pavit15/softquad/CAD_Design/README.md

# <ins>CAD Design
## <ins>Rigid Bot PArts:
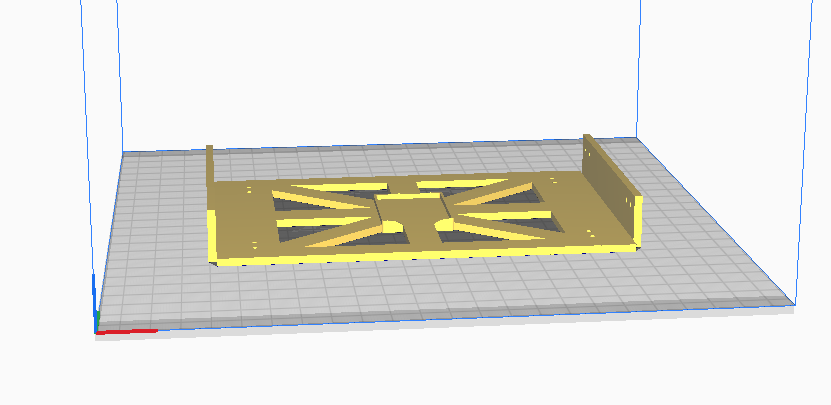
[picture p1: CAD_Design/assets/RigidChasis.png]


Rigid Bot Chasis Design

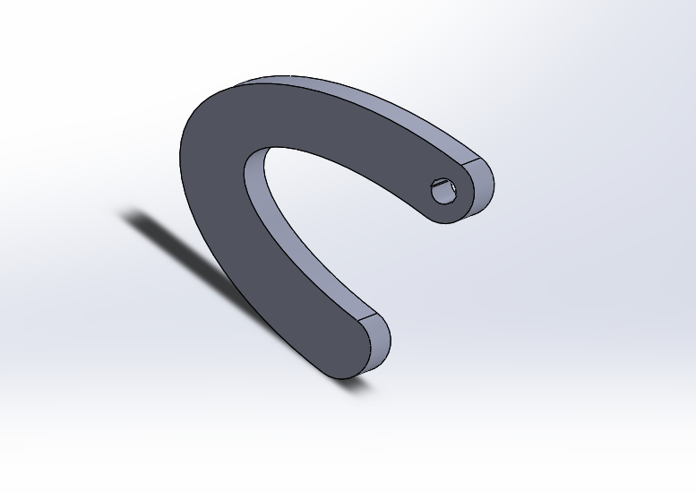
[picture p2: CAD_Design/assets/RigidLeg.png]


Rigid Leg Chasis Design

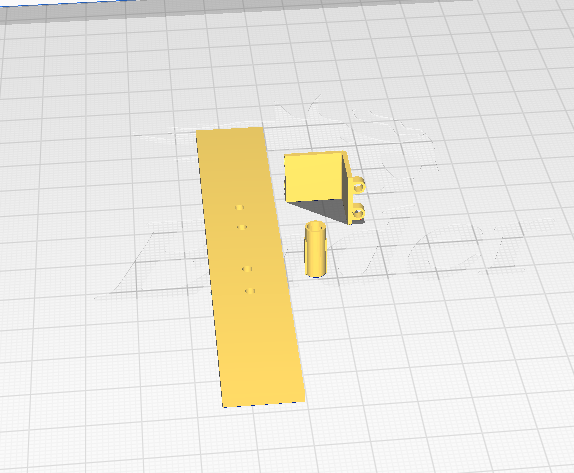
[picture p3: CAD_Design/assets/RigidParts.png]


Other parts used in Bot

## <ins>Asembly of Bot:



Motion of Bot Assembly

## <ins>Molds used for Soft Part Fabrication:
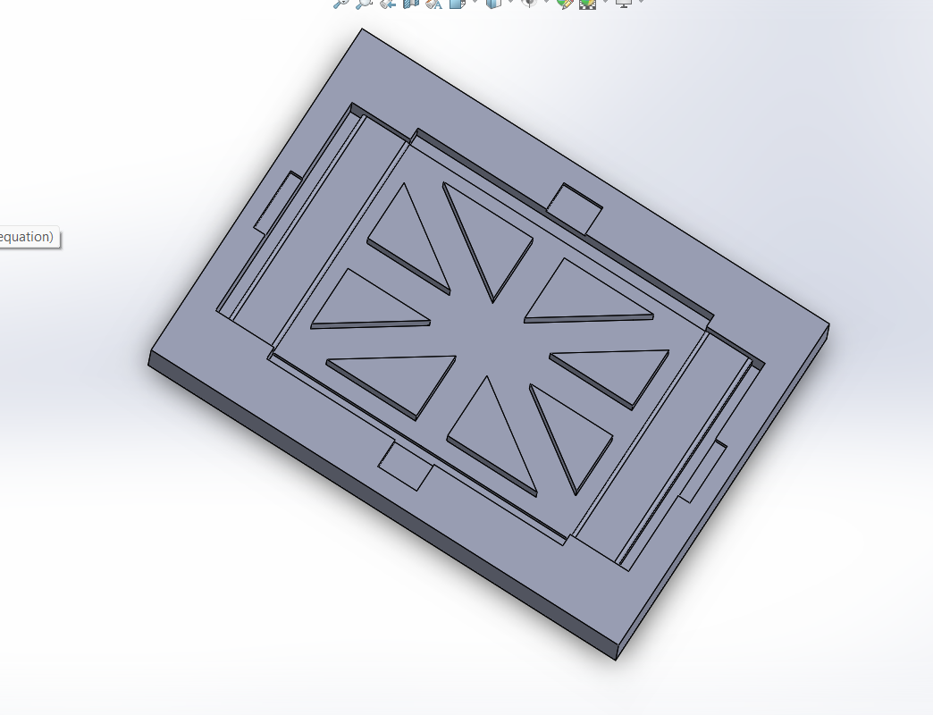
[picture p4: CAD_Design/assets/BodyMold.png]


Body Mold

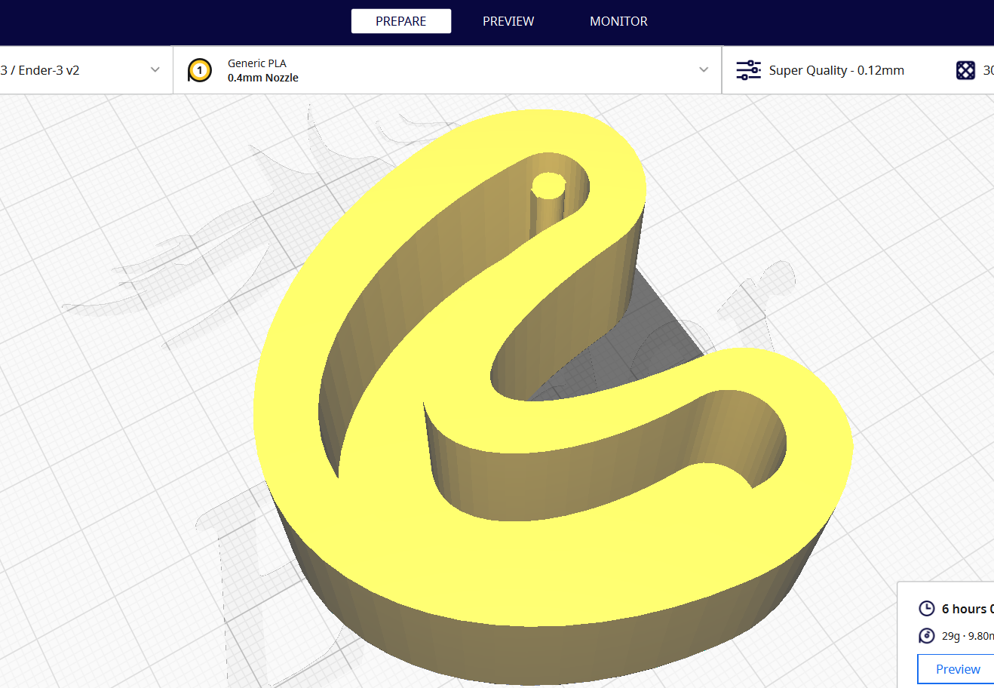
[picture p5: CAD_Design/assets/LegMold.png]


Leg Mold
