pavit15/softquad/CAD_Design/Assembly/RigidBot Assembly.SLDASM

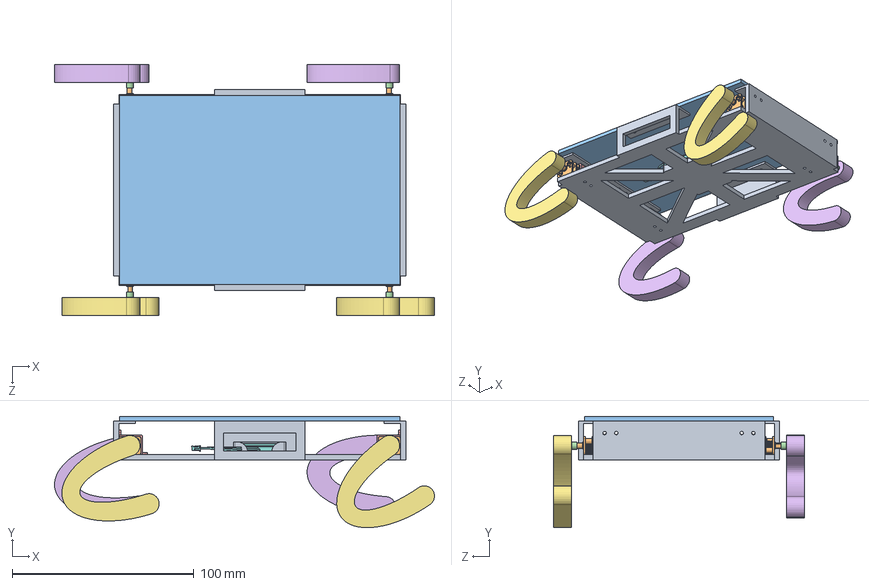
[picture p6: CAD file, 2023-11-04]
CAD_Design/Assembly/RigidBot Assembly.SLDASM
209.3 x 61.3 x 138.4 mm
RigidBody
n20_motor x 4
perfeg
ConnectorRB x 4
N20Bracket x 4
Rigid leg x 2
Rigid legL x 2
3.7v li-ion 500mah Battery.step
