pavit15/softquad/CAD_Design/Components/n20_motor.SLDPRT

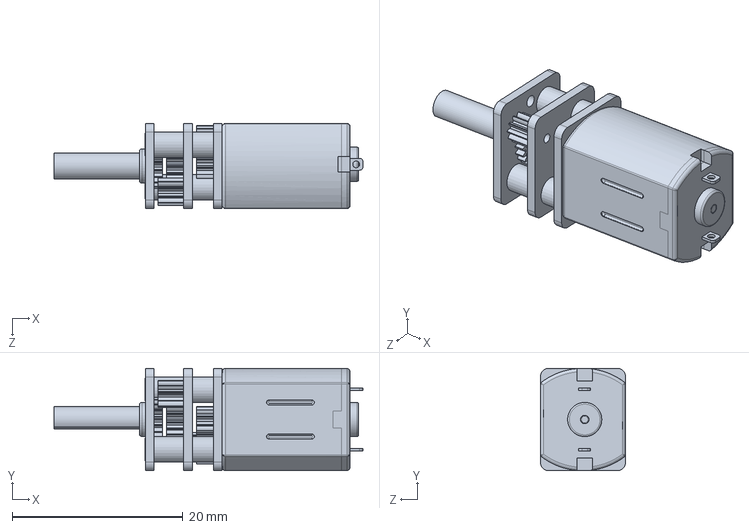
[picture p7: CAD file, 2023-11-04]
CAD_Design/Components/n20_motor.SLDPRT
36.2 x 12.0 x 10.0 mm
