pavit15/softquad/CAD_Design/Rigid_Bot_Design/ConnectorRB.SLDPRT

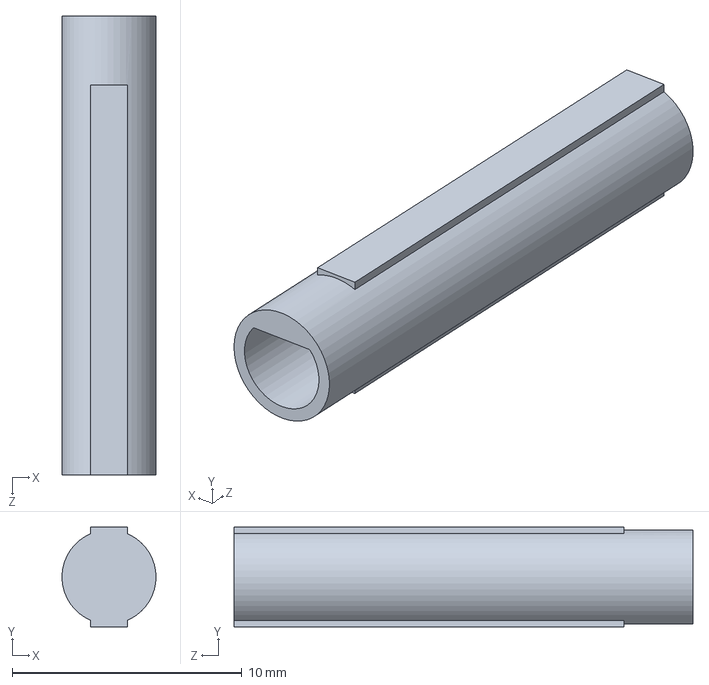
[picture p8: CAD file, 2023-11-04]
CAD_Design/Rigid_Bot_Design/ConnectorRB.SLDPRT
4.10 x 4.35 x 20.0 mm
