pavit15/softquad/CAD_Design/Soft_Quad_Molds/bodymold.SLDPRT

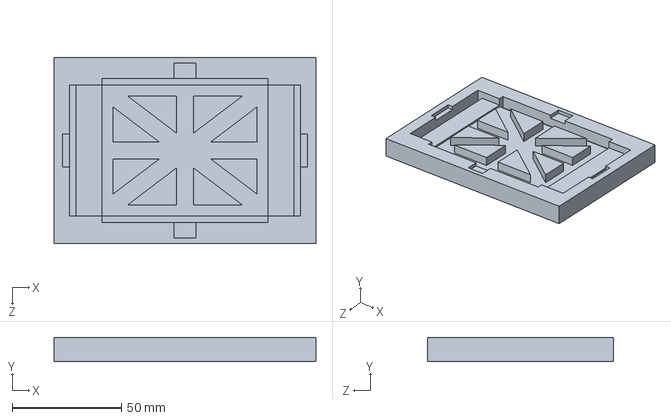
[picture p9: CAD file, 2023-11-04]
CAD_Design/Soft_Quad_Molds/bodymold.SLDPRT
120.0 x 11.0 x 85.0 mm
