pavit15/softquad/CAD_Design/STL_Files/clamps.STL

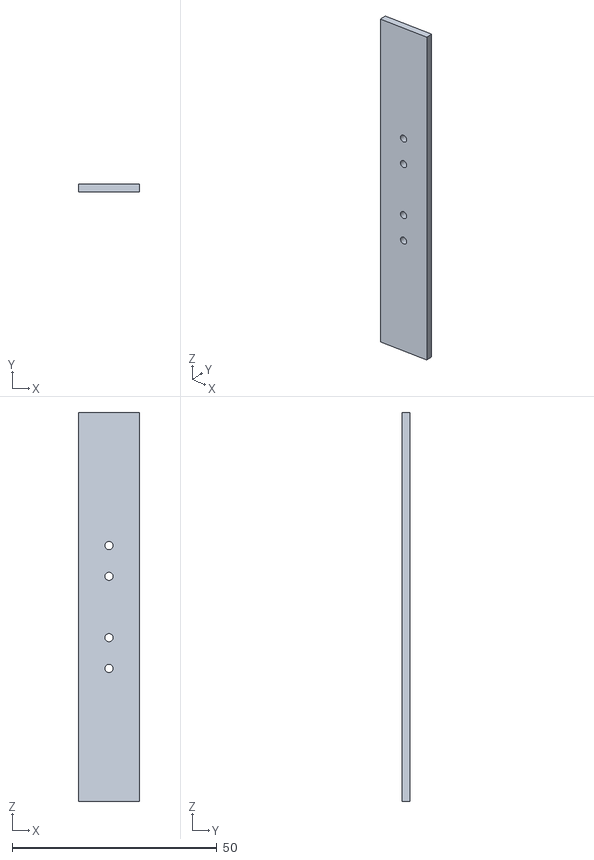
[picture p10: CAD file, 2023-11-04]
CAD_Design/STL_Files/clamps.STL
15.0 x 2.00 x 95.0
