pavit15/softquad/Kicad Rigid PCB/SoftQuad/Components/3352T-1-504LF.step

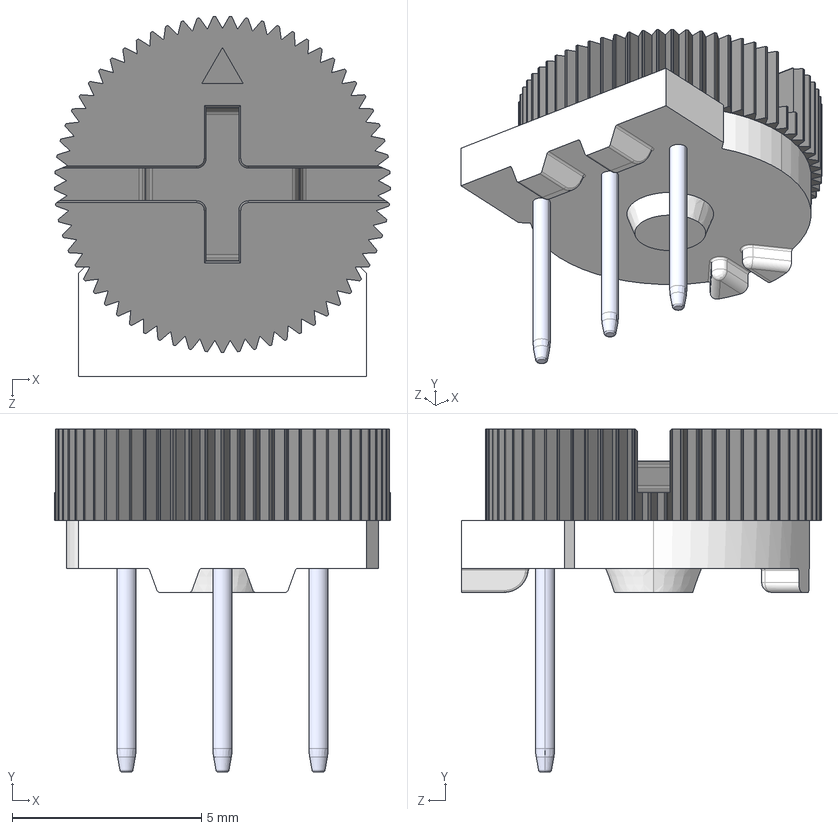
[picture p11: CAD file, 2023-11-05]
Kicad Rigid PCB/SoftQuad/Components/3352T-1-504LF.step
8.89 x 9.07 x 9.52 mm
