pavit15/softquad/Kicad Rigid PCB/XL6009.step

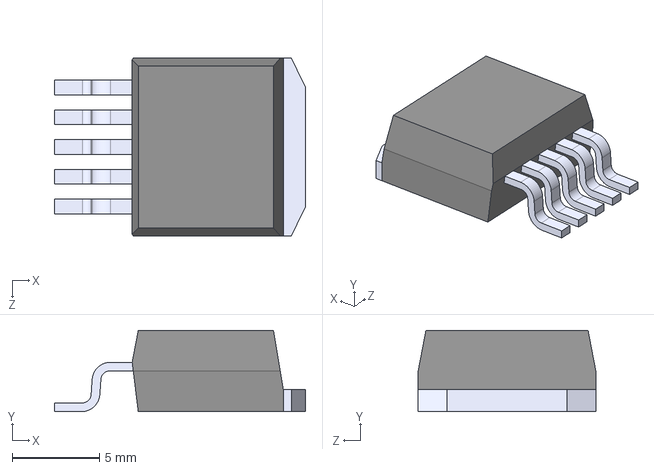
[picture p12: CAD file, 2023-11-04]
Kicad Rigid PCB/XL6009.step
14.3 x 4.65 x 10.2 mm
