pavit15/softquad/CAD_Design/Rigid_Bot_Design/N20Bracket.SLDPRT

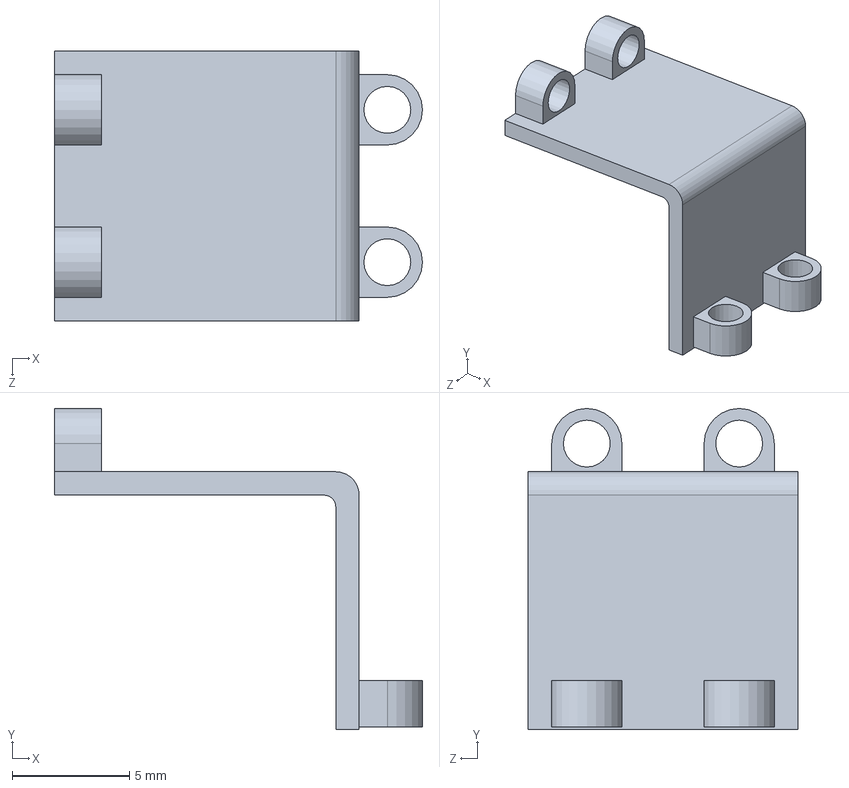
[picture p13: CAD file, 2023-11-04]
CAD_Design/Rigid_Bot_Design/N20Bracket.SLDPRT
15.7 x 13.7 x 11.5 mm
