pavit15/softquad/CAD_Design/Soft_Quad_Molds/Mold Leg.SLDPRT

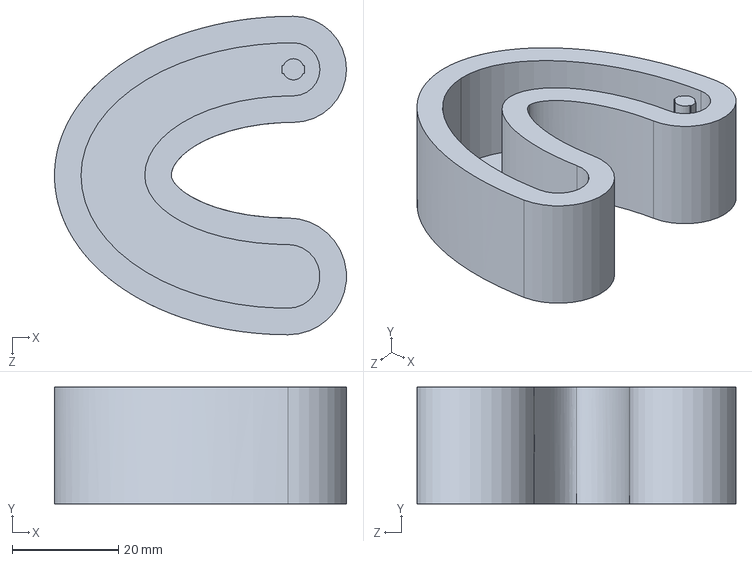
[picture p14: CAD file, 2023-11-04]
CAD_Design/Soft_Quad_Molds/Mold Leg.SLDPRT
55.0 x 22.0 x 60.0 mm
