pavit15/softquad/Kicad Rigid PCB/SoftQuad/Components/L293D.step

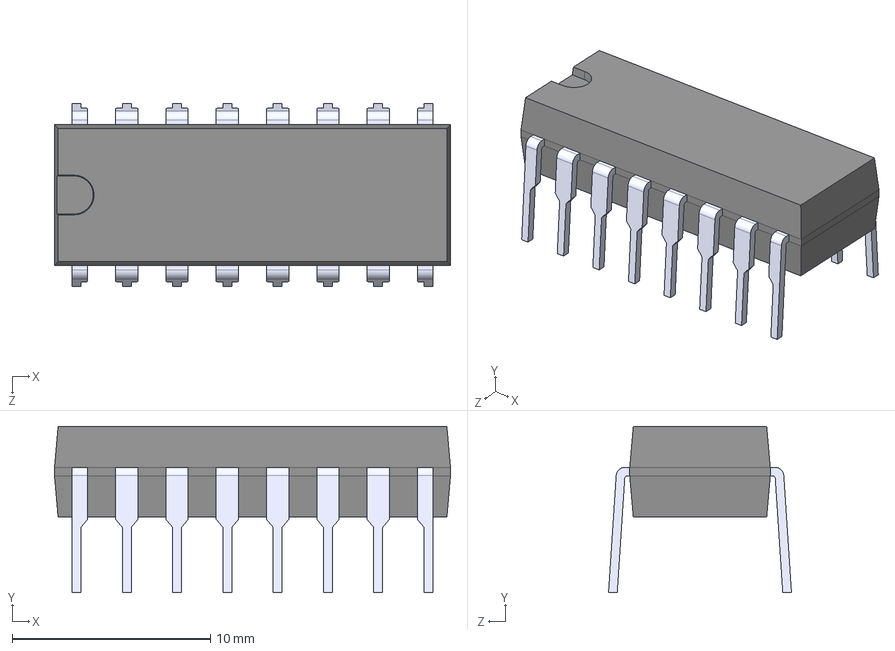
[picture p15: CAD file, 2023-11-04]
Kicad Rigid PCB/SoftQuad/Components/L293D.step
20.0 x 8.40 x 9.24 mm
