pavit15/softquad/CAD_Design/STL_Files/RigidBody.STL

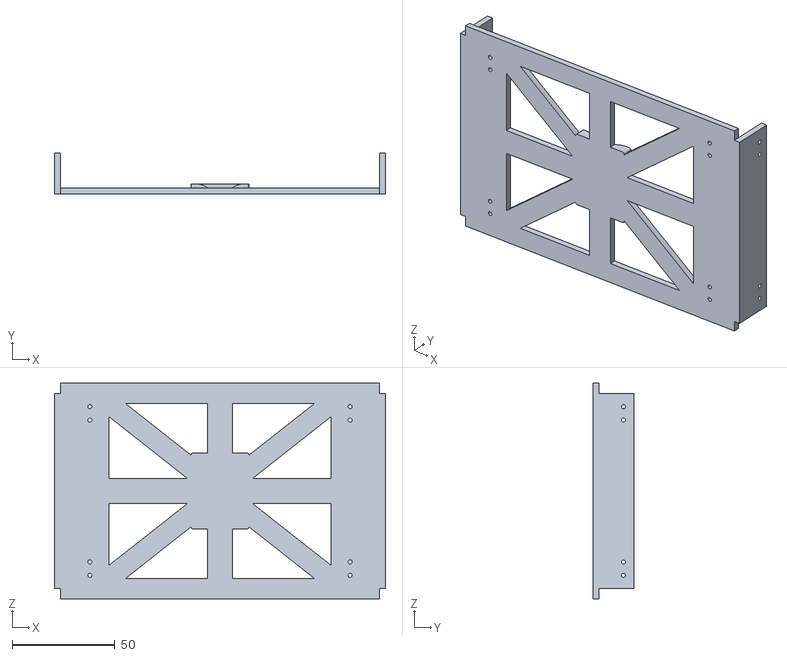
[picture p16: CAD file, 2023-11-04]
CAD_Design/STL_Files/RigidBody.STL
161.0 x 20.0 x 105.0
