pavit15/softquad/CAD_Design/Components/12V_1x02_tht.step

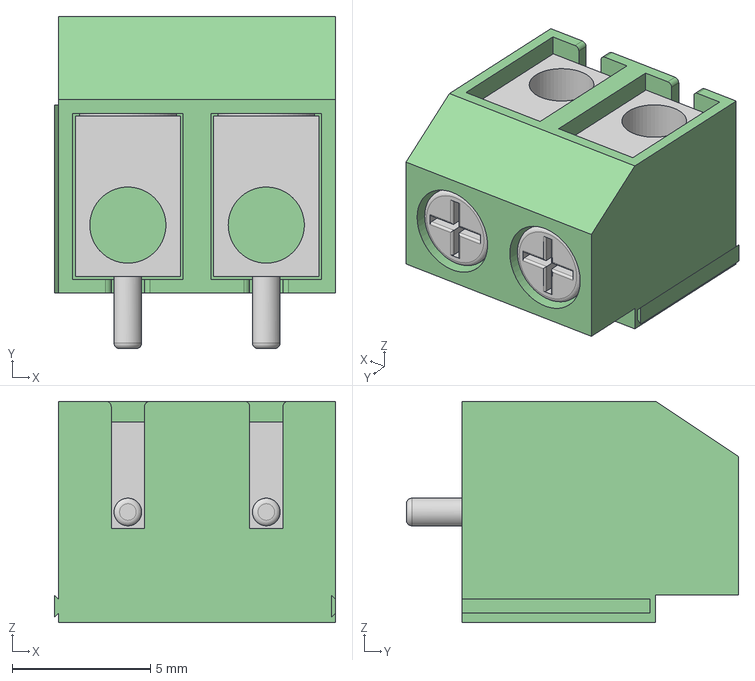
[picture p17: CAD file, 2023-11-04]
CAD_Design/Components/12V_1x02_tht.step
10.2 x 12.0 x 8.00 mm
