pavit15/softquad/CAD_Design/Rigid_Bot_Design/RigidBody.SLDPRT

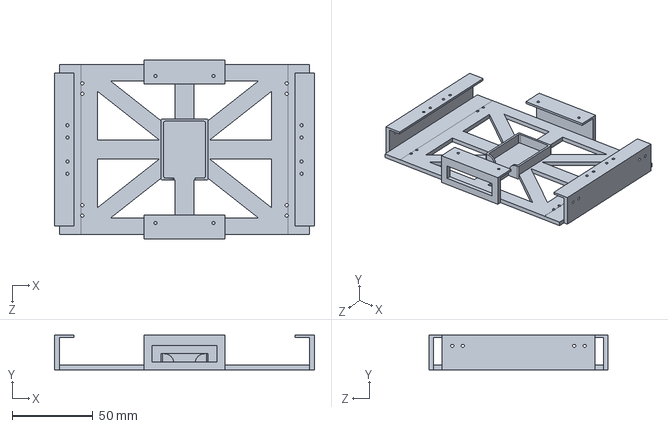
[picture p18: CAD file, 2023-11-04]
CAD_Design/Rigid_Bot_Design/RigidBody.SLDPRT
161.0 x 21.5 x 111.0 mm
