pavit15/softquad/CAD_Design/STL_Files/Rigid leg.STL

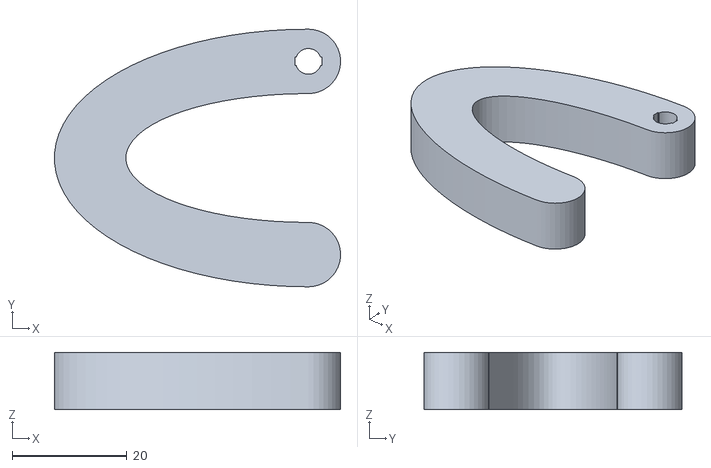
[picture p19: CAD file, 2023-11-04]
CAD_Design/STL_Files/Rigid leg.STL
50.0 x 45.0 x 10.0
