pavit15/softquad/(list of files, cad)

Other CAD files:
CAD_Design/STL_Files/N20Bracket.STL
CAD_Design/Rigid_Bot_Design/clamps.SLDPRT
CAD_Design/Rigid_Bot_Design/RigidBody1.SLDPRT
CAD_Design/STL_Files/bodymold.STL
CAD_Design/Rigid_Bot_Design/Rigid leg.SLDPRT
CAD_Design/STL_Files/ConnectorRB.STL
CAD_Design/STL_Files/Mold Leg.STL
