pavit15/softquad/(list of files, drawings)

Other design files:
Final Flex PCB/Components/4-644456-9/4-644456-9.SchLib
Final Flex PCB/Components/4-644456-9/TE_4-644456-9.PcbLib
Final Flex PCB/Components/282837-2/282837-2.SchLib
Final Flex PCB/Components/282837-2/TE_282837-2.PcbLib
Final Flex PCB/Components/CPF0603B1K0E1/CPF0603B1K0E1.SchLib
Final Flex PCB/Components/CPF0603B1K0E1/RESC1608X50N.PcbLib
Final Flex PCB/Components/L293DD/SnapEDApcb.PcbLib
Final Flex PCB/Components/L293DD/SnapEDAsch.SchLib
Final Flex PCB/Components/SS34/DIOM7959X265N.PcbLib
Final Flex PCB/Components/SS34/SS34.SchLib
Final Flex PCB/Components/TLV1117LV18DCYR/SOT230P700X180-4N.PcbLib
Final Flex PCB/Components/TLV1117LV18DCYR/TLV1117LV18DCYR.SchLib
Final Flex PCB/Components/TMS-101-02-G-D-RA/SAMTEC_TMS-101-02-G-D-RA.PcbLib
Final Flex PCB/Components/TMS-101-02-G-D-RA/TMS-101-02-G-D-RA.SchLib
Final Flex PCB/Components/TMS-101-02-G-D/SAMTEC_TMS-101-02-G-D.PcbLib
Final Flex PCB/Components/TMS-101-02-G-D/TMS-101-02-G-D.SchLib
Final Flex PCB/Components/XL6009/DPAK170P1435X465-6N.PcbLib
Final Flex PCB/Components/XL6009/XL6009.SchLib
Final Flex PCB/PCB1.PcbDoc
Final Flex PCB/Soft Quad Schematic.SchDoc
Final Flex PCB/Soft Quad.PrjPcb
