pavit15/softquad/Kicad Rigid PCB/SoftQuad/SoftQuad.kicad_pcb

## KiCad design Kicad Rigid PCB/SoftQuad/SoftQuad.kicad_pcb (2023-11-05)

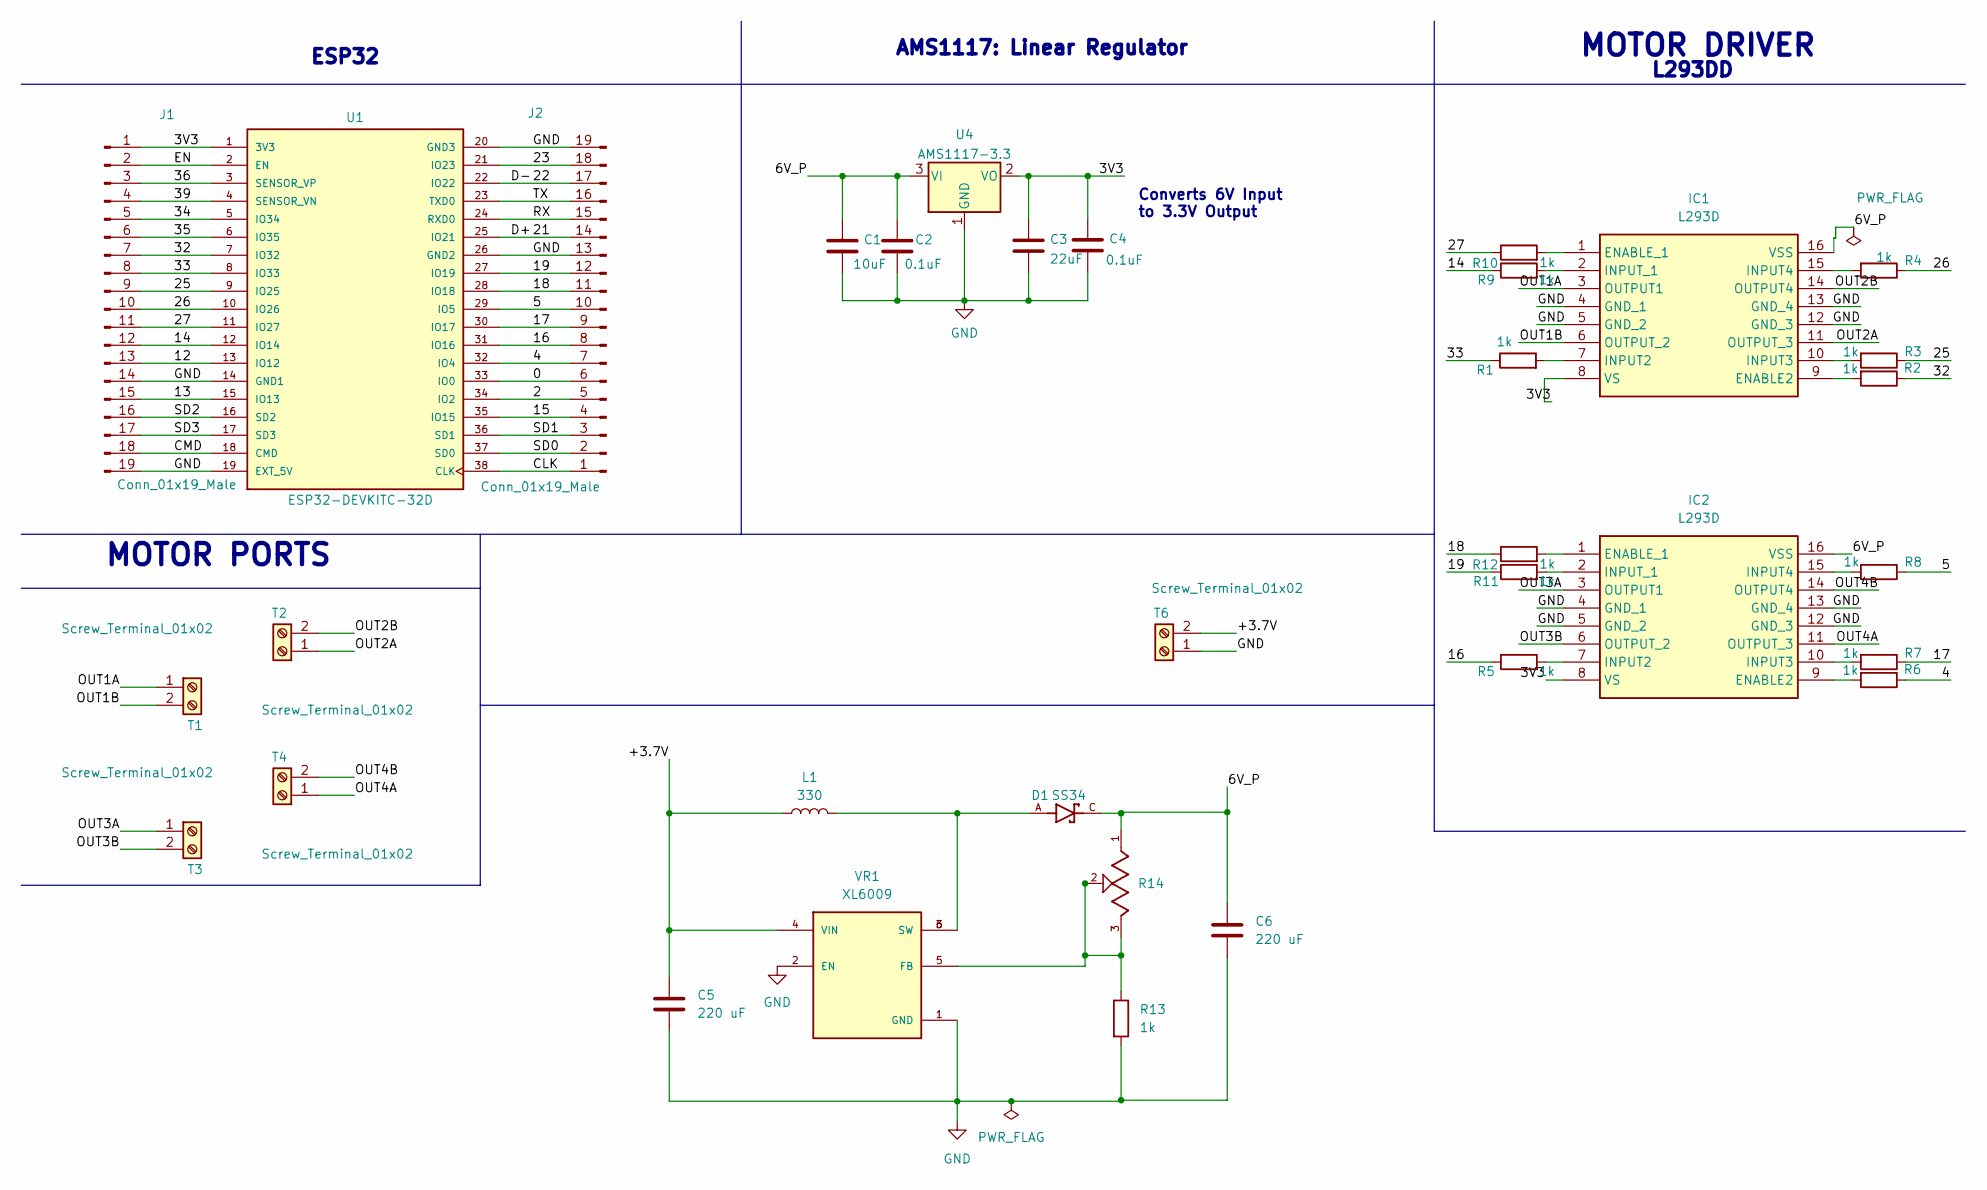
[picture p20: schematic SoftQuad.kicad_sch]

Parts:
C1: 10uF; C_0603_1608Metric
C2, C4: 0.1uF; C_0603_1608Metric
C3: 22uF; C_0603_1608Metric
C5, C6: 220 uF; C_0201_0603Metric
D1: SS34; DIOM7959X265N; PARTREV 31 Aug 2016
IC1, IC2: L293D; DIP880W50P254L2000H510Q16N; Manufacturer_Part_Number L293D; Mouser Part Number 511-L293D
J1, J2: Conn_01x19_Male; 1X19
L1: 330; L_0201_0603Metric
R1, R2, R3, R4, R5, R6, R7, R8, R9, R10, R11, R12, R13: 1k; R_0201_0603Metric
R14: 10k; TRIM_3352T-1-504LF; PARTREV 08/19
T1, T2, T3, T4, T6: Screw_Terminal_01x02; TerminalBlock_bornier-2_P5.08mm
U1: ESP32-DEVKITC-32D; ESP32-DEVKITCv4-32D; PARTREV 4
U4: AMS1117-3.3; SOT-223-3_TabPin2
VR1: XL6009; DPAK170P1435X465-6N; PARTREV 1.1

Connections:
/0: J2.6, U1.33 (IO0)
/2: J2.5, U1.34 (IO2)
/3V3: C3.1, C4.1, IC1.8 (VS), IC2.8 (VS), U1.1 (3V3), U4.2 (VO)
/4: R6.1, U1.32 (IO4)
/5: R8.1, U1.29 (IO5)
/6V_P: C1.1, C2.1, C6.1, D1.C, IC1.16 (VSS), IC2.16 (VSS), R14.1, U4.3 (VI)
/12: J1.13, U1.13 (IO12)
/13: J1.15, U1.15 (IO13)
/14: R9.1, U1.12 (IO14)
/15: J2.4, U1.35 (IO15)
/16: R5.1, U1.31 (IO16)
/17: R7.1, U1.30 (IO17)
/18: J2.11, R12.1, U1.28 (IO18)
/19: J2.12, R11.1, U1.27 (IO19)
/21: J2.14, U1.25 (IO21)
/22: J2.17, U1.22 (IO22)
/23: J2.18, U1.21 (IO23)
/25: R3.1, U1.9 (IO25)
/26: R4.1, U1.10 (IO26)
/27: R10.1, U1.11 (IO27)
/32: R2.1, U1.7 (IO32)
/33: R1.1, U1.8 (IO33)
/34: J1.5, U1.5 (IO34)
/35: J1.6, U1.6 (IO35)
/36: J1.3, U1.3 (SENSOR_VP)
/39: J1.4, U1.4 (SENSOR_VN)
/+3.7V: C5.1, L1.1, T6.2, VR1.4 (VIN)
/CLK: J2.1, U1.38 (CLK)
/CMD: J1.18, U1.18 (CMD)
/EN: J1.2, U1.2 (EN)
/OUT1A: IC1.3 (OUTPUT1), T1.1
/OUT1B: IC1.6 (OUTPUT_2), T1.2
/OUT2A: IC1.11 (OUTPUT_3), T2.1
/OUT2B: IC1.14 (OUTPUT4), T2.2
/OUT3A: IC2.3 (OUTPUT1), T3.1
/OUT3B: IC2.6 (OUTPUT_2), T3.2
/OUT4A: IC2.11 (OUTPUT_3), T4.1
/OUT4B: IC2.14 (OUTPUT4), T4.2
/RX: J2.15, U1.24 (RXD0)
/SD0: J2.2, U1.37 (SD0)
/SD1: J2.3, U1.36 (SD1)
/SD2: J1.16, U1.16 (SD2)
/SD3: J1.17, U1.17 (SD3)
/TX: J2.16, U1.23 (TXD0)
GND: C1.2, C2.2, C3.2, C4.2, C5.2, C6.2, IC1.4 (GND_1), IC1.5 (GND_2), IC1.12 (GND_3), IC1.13 (GND_4), IC2.4 (GND_1), IC2.5 (GND_2), IC2.12 (GND_3), IC2.13 (GND_4), R13.2, T6.1, U1.14 (GND1), U1.19 (EXT_5V), U1.20 (GND3), U1.26 (GND2), U4.1 (GND), VR1.1 (GND), VR1.2 (EN)
unnamed: D1.A, L1.2, VR1.3 (SW), VR1.6 (SW)
unnamed: IC1.9 (ENABLE2), R2.2
unnamed: IC1.1 (ENABLE_1), R10.2
unnamed: IC1.7 (INPUT2), R1.2
unnamed: IC1.10 (INPUT3), R3.2
unnamed: IC1.15 (INPUT4), R4.2
unnamed: IC1.2 (INPUT_1), R9.2
unnamed: IC2.9 (ENABLE2), R6.2
unnamed: IC2.1 (ENABLE_1), R12.2
unnamed: IC2.7 (INPUT2), R5.2
unnamed: IC2.10 (INPUT3), R7.2
unnamed: IC2.15 (INPUT4), R8.2
unnamed: IC2.2 (INPUT_1), R11.2
unnamed: R13.1, R14.2, R14.3, VR1.5 (FB)

Notes on the sheet:
L293DD
Converts 6V Input to 3.3V Output
MOTOR DRIVER
MOTOR PORTS
ESP32
AMS1117: Linear Regulator

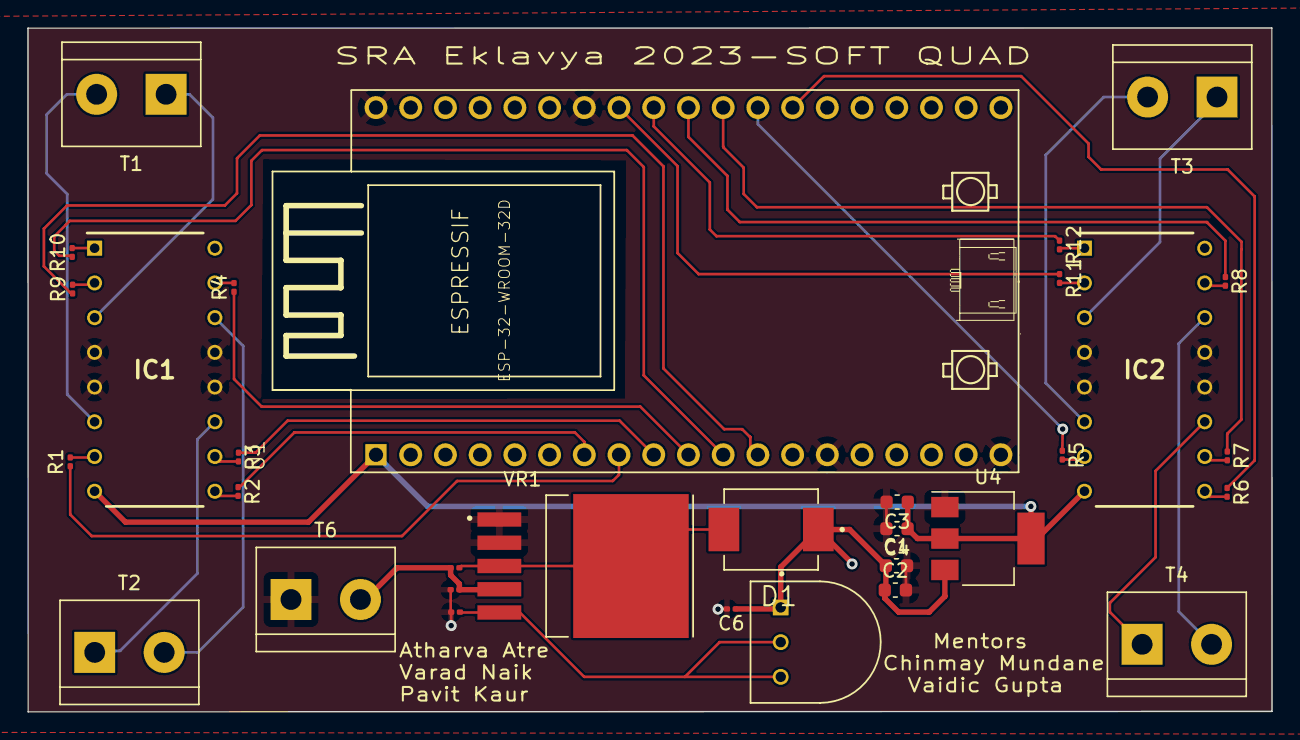
[picture p21: board SoftQuad.kicad_pcb from above]

Board: 2 copper layers, 91.0 x 50.0 mm, 32 parts (0 on the bottom side), 38 nets.
