pavit15/softquad/(threads)

Thread 5 (2023-11-02):

Add PCB_Design folder

ChinmayMundane, 2023-11-02:
- pcb folder should include 3d files, component libraries, gerbers and other necessary files

AtharvaAtre, 2023-11-05:
Issue for PCB Design solved

Closed 2023-11-05.
