pavit15/softquad/(commit log)

2023-11-04 Components used for solidworks assembly
    [12V_1x02_tht.step, L293D.step, XL6009.step, n20_motor.SLDPRT]
2023-11-04 Rigid Bot Designs
    Final Design used for 3D printing and making of Rigid Bot
    [ConnectorRB.SLDPRT, N20Bracket.SLDPRT, Rigid leg.SLDPRT, RigidBody.SLDPRT, RigidBody1.SLDPRT, clamps.SLDPRT]
2023-11-04 Mold Designs
    Molds used for Making the flexible parts
2023-11-04 Molds Solidworks
    Mold Designs used for making flexible chassis and legs
    [Mold Leg.SLDPRT, bodymold.SLDPRT]
2023-11-04 STL Files for 3D Printing
    STL files used for 3D printing the mold and parts of rigid bot
2023-11-04 STL Files used in 3D printing
    STL files used for 3D printing the parts of rigid bot and mold used in making soft bot
    [ConnectorRB.STL, Mold Leg.STL, N20Bracket.STL, Rigid leg.STL, RigidBody.STL, bodymold.STL, clamps.STL]
2023-11-04 Assembly Files
    Assembly created for bot
    [RigidBot Assembly.SLDASM]
2023-11-05 components used in assembly
    [12V_1x02_tht.step, L293D.step, XL6009.step, n20_motor.SLDPRT]
2023-11-05 Models of Rigid Bot
    [ConnectorRB.SLDPRT, N20Bracket.SLDPRT, Rigid leg.SLDPRT, RigidBody.SLDPRT, RigidBody1.SLDPRT, clamps.SLDPRT]
2023-11-05 Molds for Soft Bot Fabrication
    [Mold Leg.SLDPRT, bodymold.SLDPRT]
2023-11-05 STL Files used for 3D printing
    [ConnectorRB.STL, Mold Leg.STL, N20Bracket.STL, Rigid leg.STL, RigidBody.STL, bodymold.STL, clamps.STL]
2023-11-05 STL Files for 3D Printing
2023-11-05 Assembly of Bot in Solidworks
    [RigidBot Assembly.SLDASM]
2023-11-05 Assembly of Bot
2023-11-05 Rigid PCB(KICAD)
    [3352T-1-504LF.step, ESP32DevkitSQ.kicad_pcb, ESP32DevkitSQ.kicad_sch, L293D.step, SoftQuad.csv, SoftQuad.kicad_pcb, SoftQuad.kicad_sch, XL6009.step]
2023-11-05 CAD Designs used in Project
2023-11-05 CAD Design used in Project
2023-11-05 CAD Designs
2023-11-05 KiCAD files
    [3352T-1-504LF.step, ESP32DevkitSQ.kicad_pcb, ESP32DevkitSQ.kicad_sch, L293D.step, SoftQuad.csv, SoftQuad.kicad_pcb, SoftQuad.kicad_sch, XL6009.step]
